CXD8/Extractor/README.md

# Extractor
A smart solder extractor

# ESP32-C3 powered solder fume extractor

Controls a standard **12 V, 4-pin PWM PC fan** through an **NPN transistor**. It reads a numeric PM2.5 sensor entity from Home Assistant, lets you switch between automatic and manual control in a local phone browser, and reports tachometer RPM on that web page.
- The current housing is for a 6025 fan
- Modular, only 3D print what you need, you can stack carbon filter with hepa or only use carbon, or add a duct as you wish.

 A fan with a nonstandard actively driven tach signal may require level shifting.
- The fan receives 12 V directly from its own power supply. Do not connect fan from the ESP.
- Fan and ESP32 grounds must be connected together.
- NPN logic inversion is handled **GPIO3 transistor drive duty = 100 − requested fan PWM %**. At 100% request, NPN is OFF and the fan's PWM input is HIGH.
  
Housing
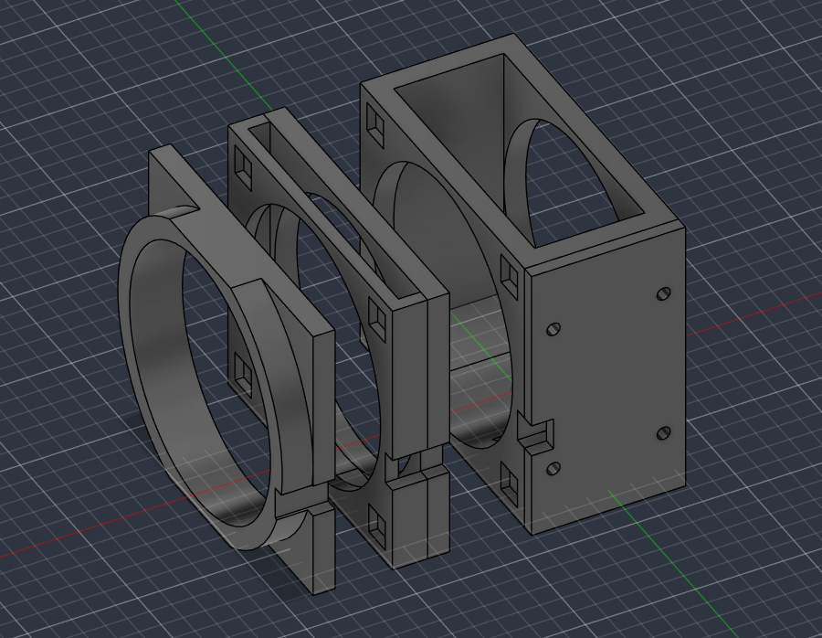
[picture p1: images/housing.PNG]
housing


Schematic
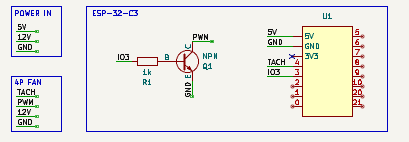
[picture p2: images/schematic.png]
schematic
  

## PM2.5 automation

| PM2.5 (µg/m³) | PWM command |
|---|---:|
| below 5 | 0% |
| 5 to below 12 | 0% |
| 12 to below 35 | 0% |
| 35 to below 75 | 20% |
| 75 and above | 85% |

- Recommended to change based on your own fan values

The sketch reads HA via the [Home Assistant REST API](https://developers.home-assistant.io/docs/api/rest/), normally every **2 seconds**. It parses the sensor's `state` as a number. The same reading at successive successful polls is **still considered fresh**. In Auto mode, unknown values, connection failures, Wi-Fi outages or a reading older than **90 seconds** command 100% fan speed. Manual mode can still control the fan when Home Assistant is offline, as long as you're on the controller's LAN.

## Security and Home Assistant differences

- **Keep the device on a trusted local network. Do not port-forward it.**
- This simple sketch talks to Home Assistant via **HTTP** so it can work with default local installs. **The long-lived token goes over the network without transport encryption** on HTTP. Protect the Wi-Fi network and Home Assistant token. For better security you can use HTTPS with proper certificate verification, which requires adapting the HTTP client code, or use MQTT with credentials/TLS.

- AN NPN transistor is not always needed, but is generally the safer option.

## Bill of Materials (BOM)

| Qty | Component | Price (USD) | Links |
|---|---|---:|---|
| 1 | ESP32-C3-MINI | $2.79 | [AliExpress](https://www.aliexpress.com/item/1005007479144456.html) |
| 1 | 6025 12V 4-pin PWM Fan | $13.86 | [AliExpress](https://www.aliexpress.com/item/1005006576690634.html) |
| 1 | 2N3904 NPN Transistor | $1.41 | [AliExpress](https://www.aliexpress.com/item/1005007205386825.html) |
| 1 | 1 kΩ Resistor | ~$2.00 | [AliExpress](https://www.aliexpress.com/item/1005002580245461.html) |
| 4 | M3x5mm Screws | $1.85 | [AliExpress](https://www.aliexpress.com/item/1005008709978631.html) |
| OPT | Activated Carbon Filter | $3.50 | [AliExpress](https://www.aliexpress.com/item/1005003090089952.html) |
| OPT | HEPA Filter | $3.29 | [AliExpress](https://www.aliexpress.com/item/1005005965425985.html) |
| **TOTAL** | **Required Components** | **~$21.91** | |
| **TOTAL + HEPA** | **Excluding Carbon Filter** | **~$25.20** | |
| **TOTAL + ALL** | **Including Both Filters** | **~$28.70** | |
