CXD8/Extractor/3d_models/full_assembly.step

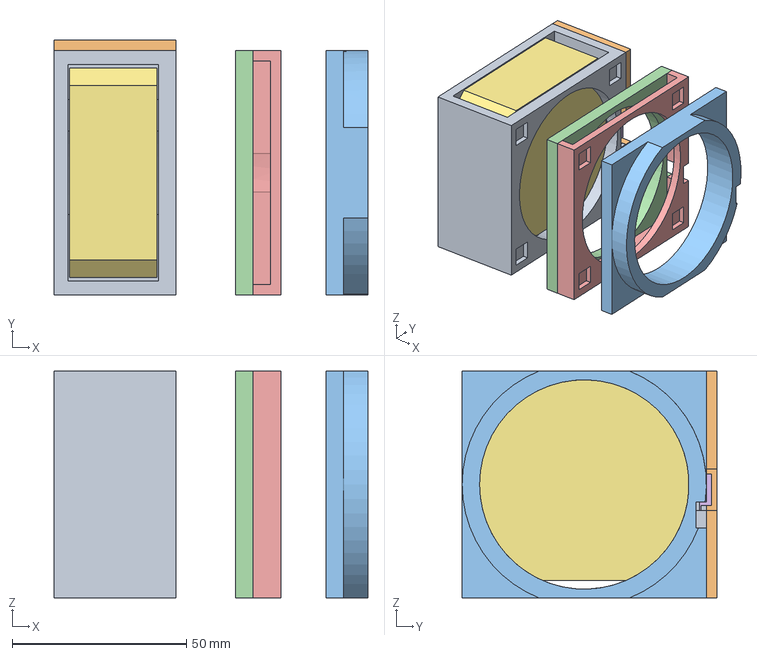
[picture p3: CAD file, 2026-10-17]
3d_models/full_assembly.step
90.0 x 73.0 x 65.0 mm
