CXD8/Extractor/3d_models/3d_model.step

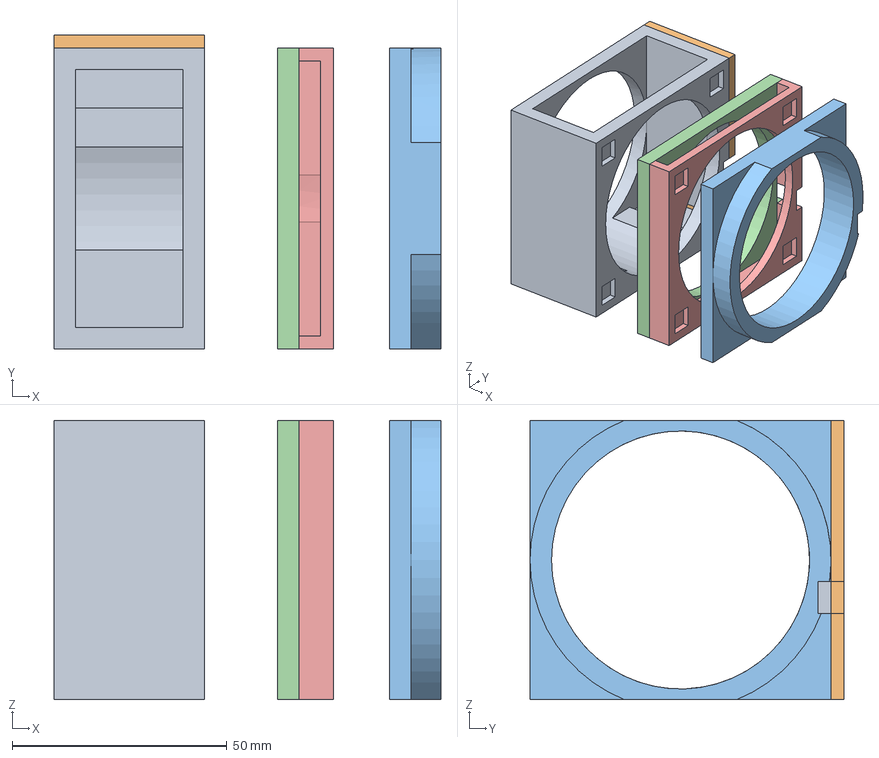
[picture p4: CAD file, 2026-10-11]
3d_models/3d_model.step
90.0 x 73.0 x 65.0 mm
