CXD8/Extractor/(list of files, cad)

Other CAD files:
3d_models/3d_model.f3d
3d_models/full_assembly.f3d
