CXD8/Extractor/schematic/schematic.kicad_sch

## KiCad design schematic/schematic.kicad_sch (2026-10-11)

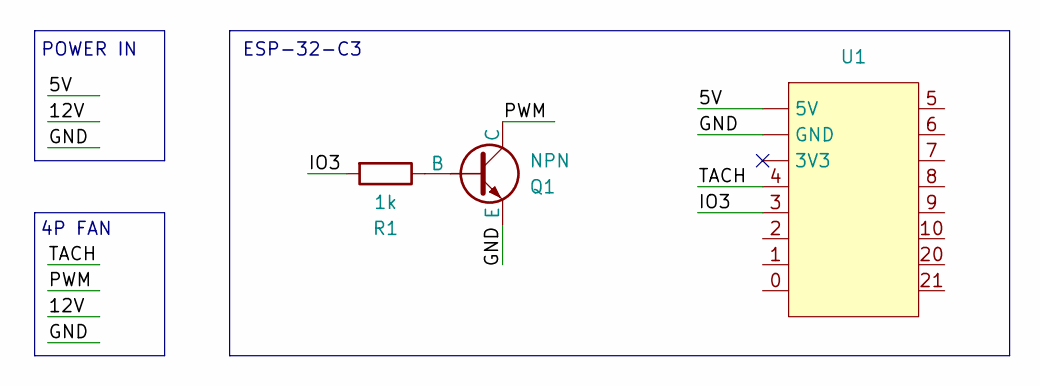
[picture p5: schematic schematic.kicad_sch]

Parts:
Q1: NPN; Nordic_AQFN-94-1EP_7x7mm_P0.4mm
R1: 1k
U1: ESP32-S2-WROVER

Connections:
5V: U1. (5V)
GND: Q1.3 (E), U1. (5V)
IO3: R1.2, U1.3
unnamed: Q1.2 (B), R1.1
PWM: Q1.1 (C)
TACH: U1.4

Notes on the sheet:
4P FAN
POWER IN
ESP-32-C3
